VizualCommander/RP2040_WildEDS/README.md

# RP2040_WildEDS
IoT environmental sensor used to predict wildfires
