VizualCommander/RP2040_WildEDS/CAD/README.txt

This folder is for CAD designs related to cases, fixtures, 3d prints, etc for WildEDS
