VizualCommander/RP2040_WildEDS/(list of files, drawings)

Other design files:
Hardware/Altium/2LayerPCBTemplateWWU.PcbDoc
Hardware/Altium/BSheetSchematicTemplateWWU.SchDoc
Hardware/Altium/PCB_Prototype_JossBaldeep.PrjPcb
Hardware/Altium/SeniorProject.PcbLib
Hardware/Altium/SeniorProject.SchLib
