VizualCommander/RP2040_WildEDS/Hardware/KiCad/RP2040_WEDS.kicad_pcb

## KiCad design Hardware/KiCad/RP2040_WEDS.kicad_pcb (2022-02-18)

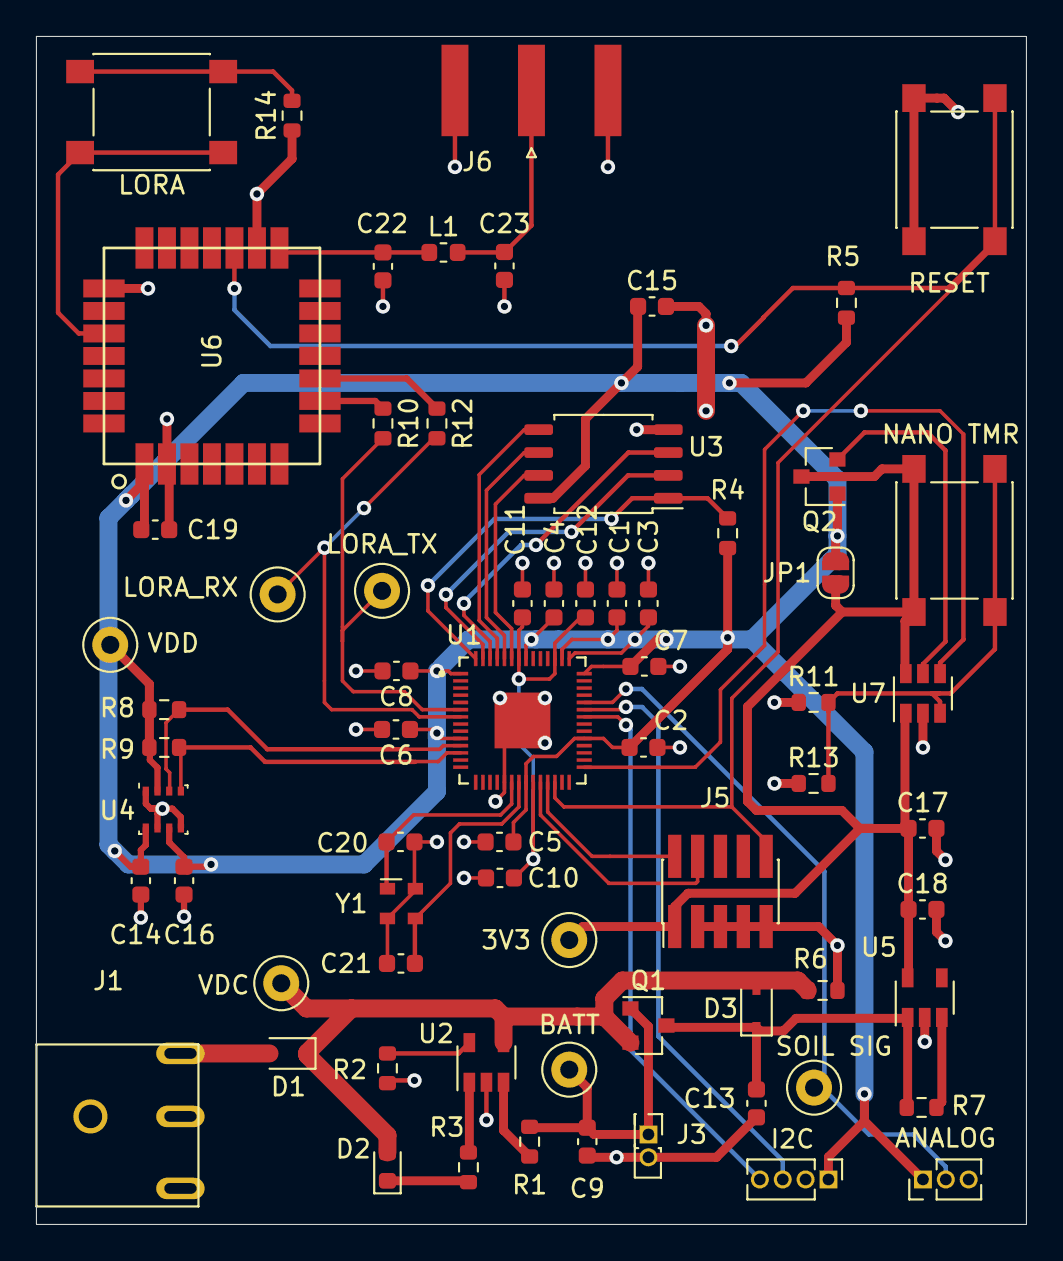
[picture p2: board RP2040_WEDS.kicad_pcb from above]

Board: 2 copper layers, 55.0 x 66.0 mm, 68 parts (0 on the bottom side), 40 nets.

Parts:
3V3: TestPoint; TestPoint_Loop_D1.80mm_Drill1.0mm_Beaded
ANALOG: Conn_01x03_Male; PinHeader_1x03_P1.27mm_Vertical
BATT: TestPoint; TestPoint_Loop_D1.80mm_Drill1.0mm_Beaded
C1, C12: 1uF; C_0603_1608Metric
C2, C3, C4, C5, C6, C7, C8, C10, C11, C14, C16: 100nF; C_0603_1608Metric
C9, C13, C17, C18: 10uF; C_0603_1608Metric
C15: C; C_0603_1608Metric
C19: 4.7uF; C_0603_1608Metric
C20, C21: 8pF; C_0603_1608Metric
C22, C23: DNP; C_0603_1608Metric
D1, D3: D_Schottky; D_SOD-323
D2: LED; LED_0603_1608Metric
I2C: Conn_01x04_Male; PinHeader_1x04_P1.27mm_Vertical
J1: Barrel_Jack_Switch_Pin3Ring; 54-00125
J3: LiPo Batt; PinHeader_2x01_P1.27mm_Vertical
J5: Conn_02x05_Odd_Even; PinHeader_2x05_P1.27mm_Vertical_SMD
J6: SMA-J-P-H-RA-TH1; SMA_Amphenol_132289_EdgeMount_new
JP1: SolderJumper_2_Open; SolderJumper-2_P1.3mm_Open_RoundedPad1.0x1.5mm
L1: 0H; L_0603_1608Metric
LORA: SW_Push; SW_Push_1P1T_NO_6x6mm_H9.5mm
LORA_RX: TestPoint; TestPoint_Loop_D1.80mm_Drill1.0mm_Beaded
LORA_TX: TestPoint; TestPoint_Loop_D1.80mm_Drill1.0mm_Beaded
NANO TMR: SW_Push; SW_Push_1P1T_NO_6x6mm_H9.5mm
Q1, Q2: Q_PMOS_DGS; SOT-23
R1: 0; R_0603_1608Metric
R2: 2k; R_0603_1608Metric
R3, R4, R5, R6, R7, R8, R9: 10k; R_0603_1608Metric
R10, R12: 22; R_0603_1608Metric
R11: 221k; R_0603_1608Metric
R13: 287k; R_0603_1608Metric
R14: 470; R_0603_1608Metric
RESET: SW_Push; SW_Push_1P1T_NO_6x6mm_H9.5mm
SOIL SIG: TestPoint; TestPoint_Loop_D1.80mm_Drill1.0mm_Beaded
U1: RP2040; QFN40P700X700X90-57N
U2: MCP73831-2-OT; SOT-23-5
U3: W25Q128JVS; SOIC-8_5.23x5.23mm_P1.27mm
U4: BME280; Bosch_LGA-8_2.5x2.5mm_P0.65mm_ClockwisePinNumbering
U5: AP2112K-3.3; SOT-23-5
U6: LoRa-E5
U7: TPL5110; SOT-23-6
VDC: TestPoint; TestPoint_Loop_D1.80mm_Drill1.0mm_Beaded
VDD: TestPoint; TestPoint_Loop_D1.80mm_Drill1.0mm_Beaded
Y1: Crystal_GND24; Oscillator_SMD_Abracon_ASDMB-4Pin_2.5x2.0mm

Connections:
+1V1: C10.1, C11.1, C12.1, U1.23, U1.45, U1.50
+3V3: 3V3.1, C17.1, C18.1, J5.1, JP1.1, NANO TMR.2, Q2.3, U5.5, U7.1, U7.6
+BATT: BATT.1, C9.1, J3.1, Q1.1, R1.1
DONE: U1.29, U7.4
GND: ANALOG.3, C1.2, C2.2, C3.2, C4.2, C5.2, C6.2, C7.2, C8.2, C9.2, C10.2, C11.2, C12.2, C13.2, C14.2, C15.2, C16.2, C17.2, C18.2, C19.2, C20.2, C21.1, C22.2, C23.2, I2C.2, J1.2, J1.3, J3.2, J5.3, J5.5, J5.7, J5.9, J6.2, J6.3, J6.4, J6.5, R2.1, R6.2, R11.1, R13.1, R14.1, RESET.2, U1.19, U1.57, U2.2, U3.4, U4.1, U4.5, U4.7, U5.2, U6.2, U6.16, U6.22, U7.2, Y1.2, Y1.4
LORA_RX: LORA_RX.1, R12.2, U1.7
LORA_TX: LORA_TX.1, R10.2, U1.6
unnamed: C13.1, D3.1, Q1.3, R7.2, U5.1
unnamed: C22.1, L1.1, U6.15
unnamed: C23.1, J6.1, L1.2
unnamed: D1.2, J1.1
unnamed: D2.1, R3.1
unnamed: Q2.2, U7.5
unnamed: R1.2, U2.3
unnamed: R2.2, U2.5
unnamed: R3.2, U2.1
unnamed: R7.1, U5.3
unnamed: R10.1, U6.9
unnamed: NANO TMR.1, R11.2, R13.2, U7.3
unnamed: R12.1, U6.10
unnamed: LORA.2, R14.2
unnamed: LORA.1, U6.24
QSPI_CLK: U1.52, U3.6
QSPI_CSN: R4.1, U1.56, U3.1
QSPI_SD0: U1.53, U3.5
QSPI_SD1: U1.55, U3.2
QSPI_SD2: U1.54, U3.3
QSPI_SD3: U1.51, U3.7
RESET: J5.10, R5.2, RESET.1, U1.26, U6.17
SCL: R9.2, U1.12, U4.4
SCL_SOIL: I2C.3, U1.37
SDA: R8.2, U1.11, U4.3
SDA_SOIL: I2C.4, U1.36
SOIL_SIG: ANALOG.2, SOIL SIG.1, U1.38
SWD_CLK: J5.4, U1.24
SWD_DIO: J5.2, U1.25
VDC: D1.1, D2.2, D3.2, Q1.2, R6.1, U2.4, VDC.1
VDD: ANALOG.1, C1.1, C2.1, C3.1, C4.1, C5.1, C6.1, C7.1, C8.1, C14.1, C15.1, C16.1, C19.1, I2C.1, JP1.2, Q2.1, R4.2, R5.1, R8.1, R9.1, U1.1, U1.10, U1.22, U1.33, U1.42, U1.43, U1.44, U1.49, U3.8, U4.2, U4.6, U4.8, U6.1, VDD.1
XIN: C20.1, U1.20, Y1.1
XOUT: C21.2, U1.21, Y1.3
