VizualCommander/RP2040_WildEDS/(commit log)

2022-02-11 KiCad files added
    [RP2040_WEDS-B_Cu.gbl, RP2040_WEDS-B_Mask.gbs, RP2040_WEDS-B_SilkS.gbo, RP2040_WEDS-Edge_Cuts.gm1, RP2040_WEDS-F_Cu.gtl, RP2040_WEDS-F_Mask.gts, RP2040_WEDS-F_SilkS.gto, RP2040_WEDS-NPTH.drl]
2022-02-11 Test push
    [RP2040_WEDS.kicad_pcb]
2022-02-11 updated gerber files
    [RP2040_WEDS-B_Cu.gbl, RP2040_WEDS-B_Mask.gbs, RP2040_WEDS-B_SilkS.gbo, RP2040_WEDS-Edge_Cuts.gm1, RP2040_WEDS-F_Cu.gtl, RP2040_WEDS-F_Mask.gts, RP2040_WEDS-F_SilkS.gto, RP2040_WEDS-NPTH.drl]
2022-02-11 added KiCad folder
    [RP2040_WEDS.kicad_pcb, RP2040_WEDS.sch]
2022-02-11 added new folders and Altium files
    [2LayerPCBTemplateWWU.PcbDoc, BSheetSchematicTemplateWWU.SchDoc, PCB_Prototype_JossBaldeep.PrjPcb, SeniorProject.PcbLib, SeniorProject.SchLib]
2022-02-11 created kicad gerber subfolder
    [RP2040_WEDS-B_Cu.gbl, RP2040_WEDS-B_Mask.gbs, RP2040_WEDS-B_SilkS.gbo, RP2040_WEDS-Edge_Cuts.gm1, RP2040_WEDS-F_Cu.gtl, RP2040_WEDS-F_Mask.gts, RP2040_WEDS-F_SilkS.gto, RP2040_WEDS-NPTH.drl]
